Lorentz-DC/ESP32-RC-Rover-with-POV-Cam/(commit log)

2026-10-29 Add files via upload
    ESP32 RC Rover Code, Oct 28. runs BluePad32 Bluetooth protocol to connect with PS4 controller, if PS4 controller is not connected, runs on IR receiver mode for lab testing. runs INA219 current sensor; motion functions include joystick motor control of dir and PWM values on 4 DC motors, capable of forward, throttle, veer and spin turn; reverse actions is not complete yet; stepper motor control for POV camera is not complete yet.
2026-10-29 Add demo links to README
    Added demo links for the ESP32 RC Rover project.
2026-10-29 Add wiring schematics to README
2026-10-29 Update README with POV cam and wiring details
    Added details about the POV camera and wiring schematics.
2026-10-29 Change PWM simulation image reference
    Updated the image reference for the motor driver PWM simulation from 'PWM_simulation.gif' to 'PWM_demo.gif'.
2026-10-29 Change PWM simulation image to larger version
    Updated the image reference for the motor driver PWM simulation in the README.
2026-10-29 Fix image link for drawn schematics
    Updated the image link for drawn schematics in the README.
2026-10-29 Change drawn schematics image reference
    Updated the image reference for drawn schematics in the README.
2026-10-29 Add demo images to README
    Added demo images for rover and POV camera.
2026-10-29 Update README with PWM output voltage details
    Added additional details about the PWM simulation output voltages.
2026-11-02 Add wiring schematics and simulation details to README
2026-11-02 Fix image paths and add assembly images in README
    Updated image paths to use the 'media' directory and added assembly images.
2026-11-02 Add images for robot assembly and wiring schematics
2026-11-02 Revise README formatting and add new sections
    Updated formatting and added new sections for PWM Simulation, Code Structure, and Troubleshooting.
2026-11-02 Revise project description in README.md
    Updated project description to provide more details about the components and features of the ESP32 rover.
2026-11-02 Fix typo in README project description
    Corrected 'POV cam' to 'POV camera' in project description.
2026-11-04 Add files via upload
    improved motor control architecture from troublesome analogWrite() depending on millis() gating and vTaskdelay() to gate-latched, modular and parameterized individual motor functions that operates at full clockspeed.
2026-11-04 Rename file to improved motor control architecture
2026-11-04 Clarify motor control functions in README
    Updated code structures section to clarify motor control functions.
2026-11-04 Clarify joystick controls and ESP32 functions in README
    Updated code structures section to clarify joystick controls and added details on ESP32 functions.
2026-11-04 Enhance README with troubleshooting details
    Updated troubleshooting section to include Bluetooth drop-out problem and MOSFET shoot-through protection.
2026-11-08 Add files via upload
    Updated motor control architecture with modular and parameterized individual motor control function; This version achieves true value differential gate Latching (to prevent flooding hardware registers. The new framework is completely non-blocking, freeing up the CPU clock cycle loop, compared to loop structures in the previous version, which depended heavily on asynchronous wrapping frameworks, millis() step gates, or FreeRTOS vTaskDelay() markers that caused background processing jitter.
2026-11-08 Revise README.md for component details and functionality
    Updated component descriptions and clarified functionality of the POV camera system.
2026-11-13 Enhance project description in README
    Updated README to include details on wiring for galvanic isolation.
2026-11-14 Update README with motor control details
    Added motor control structure and relevant code references.
2026-11-14 Enhance README with motor control and troubleshooting details
    Updated README to include execution layers, motor control logic, and troubleshooting information.
2026-11-14 Revise troubleshooting and power management details
    Updated troubleshooting section with detailed analysis of Bluetooth dropout issues related to power and signal integrity. Added measurements and observations regarding voltage fluctuations and battery management.
2026-11-14 Update README with power rail measurement analysis
    Added analysis of filtered and unfiltered power rail measurements for the ESP32, including effects of battery capacity on voltage stability.
2026-11-14 Enhance README with detailed filter circuit explanation
    Clarified the description of the decoupling circuit and its effects on voltage stability for the ESP32.
2026-11-14 Enhance README with ESP32 power supply analysis
    Added detailed analysis of ESP32 power supply and battery performance under load, including oscilloscope measurements and voltage comparisons.
2026-11-14 Update README with improved voltage measurement details
    Clarified the description of the voltage measurements and battery capacity issues.
2026-11-14 Enhance README with troubleshooting details for Bluetooth issues
    Expanded on the Bluetooth dropout issue when running multiple motors, detailing troubleshooting steps and oscilloscope measurements. Added information on decoupling circuit effectiveness and battery capacity problems.
2026-11-14 Revise section title and add troubleshooting details
    Updated section title and provided details on Bluetooth drop-out issues related to power integrity.
2026-11-14 Enhance README with Bluetooth dropout troubleshooting details
    Expanded on the Bluetooth dropout issue caused by voltage drops during motor operation, detailing troubleshooting steps and oscilloscope measurements.
2026-11-14 Update wiring and schematics for ESP32 supply line
    Removed the buck converter from the ESP32 supply line and added a separate 8V line with a decoupling filter circuit to address voltage brown-out issues.
